vector76/big_arm/docs/open-questions.md

# Open questions

The ⭐ items block the most downstream work. Answers get folded into
[requirements.md](requirements.md) and new design docs as they arrive.

## Still open

1. **Sensing details.** The core concept is now captured in
   [sensing.md](sensing.md) — unloaded-reference optical metrology (readout
   gears for joint angles, floating reference beams for link bending, cheap
   camera modules as the universal readout). Remaining sensing-specific
   questions (sensor count/placement, camera data path, calibration method,
   upper-arm beam geometry) live at the bottom of that document.
2. **Reduction mechanism trade.** Analysis and measurement plan in
   [reduction-trade.md](reduction-trade.md). Shoulder leading hypothesis:
   printed herringbone primary (6.375:1) + capstan cable
   sector (~23.5:1) — η ≈ 0.85, margin ~1.96, zero backlash, drift killed by
   absolute optical sensing. Wrist leans worm; elbow leans worm if measured
   η ≥ 0.5. Closes when the bench rig produces measured efficiencies.
3. **Required feedback resolution and rate.** The repeatability target
   (±1 mm mandatory / 0.1 mm stretch) gives a ~1.1 mrad total angular
   budget — roughly 0.3 mrad per contributor. Rate still open; slow motion
   means even ~10 Hz correction may be plenty. Validate against the Phase 1b
   sensing measurements.
4. **Material trade: plywood box-truss vs. inexpensive pine boards.** Nothing
   purchased yet. Pine boards are cheap and need no sheet-cutting; plywood
   trusses have better strength-to-weight and suit the CNC. Could mix.
5. **Counterweight material and form.** Cheap dense mass: steel bar stock,
   concrete, sand-filled boxes, scrap? How weights mount and adjust (fixed
   vs. positionable along the stub)? Joint-mounted motors contribute some
   mass but nowhere near enough on their own. Note the stub-length limit
   (~half link length) roughly doubles the required mass vs. a full-length
   stub.

The first milestone question is resolved: the concept model is scaffolded
and running in `model/` (torque/counterbalance math + 3D view). With the
datasheet motor curve, load-adaptive cruise speeds, and the elbow restricted
to downward bending, traverse lands at ~2.9 s unloaded / ~6.8 s loaded
(worst joint, full travel) — both the ~10 s unloaded target and the hoped-for
~10 s loaded are met. Shoulder moving margin is 1.61 (pull-out based).
Next milestones: single-joint testbed, then full-arm CAD in OpenSCAD.

## Resolved

### 2026-07-09 (ninth round)

- **Anti-backlash gear primitive:** radially-preloaded printed herringbone
  pairs (compliant mechanism maintains slight center pressure) — proven in
  the user's prior work, effectively zero backlash. Preferred primary-stage
  building block.
- **Shoulder drivetrain hypothesis:** herringbone primary + capstan cable
  sector, ~150:1 total, first prototype of Phase 1a; becomes the final
  design if it measures well.
- **Testbed geometry:** real 0.45 m upper-arm length with balanced dummy
  elbow mass + unbalanced torque-equivalent load — not a full-length
  surrogate beam — so deflection sensing and calibration transfer 1:1.

### 2026-07-09 (eighth round)

- **Repeatability target:** ±1 mm at the tool tip mandatory; ±0.1 mm
  stretch goal after full calibration and modeling. Closes Phase 0.

### 2026-07-09 (seventh round)

- **v0 design point locked** (see requirements.md): default model
  parameters with elbow 90:1 and wrist 40:1 (low enough for single-stage,
  non-bulky reductions), shoulder 150:1, yaw 60:1. Holding torque modeled
  at 0.41 N·m — equal to pull-out — treating the quoted 59 N·cm as
  optimistic. Margins 1.61 / 1.94 / 3.90; traverse ~2.9 s unloaded,
  ~6.8 s loaded.
- **Reduction preference:** single-stage strongly preferred at elbow and
  wrist (no bulky large gears, no multi-stage trains). Constrains the
  Phase 1a trade study.

### 2026-07-08 (sixth round)

- **Motors:** the nine on-hand NEMA 17s are StepperOnline 17HS19-2004S1
  (59 N·cm holding, 2 A, 48 mm); 24 V supply to the drivers. Fans possible
  if needed. Datasheet torque curve at 24 V / 2.2 A: pull-out ~41 N·cm flat
  to ~450 rpm, roughly linear decline to ~17 N·cm at 1200 rpm.
  <https://www.omc-stepperonline.com/nema-17-bipolar-59ncm-84oz-in-2a-42x48mm-4-wires-w-1m-cable-connector-17hs19-2004s1>
- **Elbow range of motion:** downward bend only (~135° travel). With ±90°
  wrist travel the same points stay reachable except some above the
  shoulder. Shrinks worst-case traverse and simplifies counterweight
  clearance.

### 2026-07-08 (fifth round)

- **Modeling/CAD tooling:** documented in [tooling.md](tooling.md).
  A self-contained client-side **TypeScript + three.js engineering model**
  (no server — all math is closed-form and runs in the browser; Vite build;
  hostable as static files) for the concept/trade-study phase, with a pure
  model-core module separated from rendering. **OpenSCAD** as the geometry
  source of truth for detailed design. **Python** reserved for offline
  analysis scripts once measured data exists (e.g., calibration fitting) —
  not a live server. FreeCAD held in reserve for STEP/FEM needs; OnShape and
  paid CAD out.

### 2026-07-08 (fourth round)

- **Optical feedback concept:** captured in [sensing.md](sensing.md). Core
  principle: compare loaded members against unloaded optical references —
  an unloaded anti-backlash readout gear pair per joint (amplified rotation
  read by camera via fiducial tag), and a free-floating carbon-fiber
  reference beam alongside long links (deflection read by a macro-focus
  camera on the loaded structure). ESP32-CAM-class modules (<$10) as the
  readout everywhere. Global workspace camera demoted to coarse cross-check.
  Precision comes from offline load/pose calibration fitting a structural
  model that includes unmeasured compliances (bench, base).

### 2026-07-08 (third round)

- **Wrist link:** no counterweight. Short, light, and dominated by
  end-effector mass; the resulting imbalance is accepted and absorbed by the
  motors. Possibly an attachment point for an optional counterweight for
  very heavy end effectors.
- **Exactness of balance:** perfect neutrality is *not* required — the
  unbalanced wrist link settles this in principle; the motors' torque budget
  absorbs residual imbalance.
- **Counterweight stub length:** limited to ~half the length of the parent
  link, to avoid collisions and workspace restriction.
- **CNC work envelope:** ~3 ft × ~2 ft.

### 2026-07-08 (second round)

- **Payload rating convention:** 5 lb is the minimum over the entire
  workspace, including full extension; more is expected closer in.
- **Speed floor:** any pose to any pose, unloaded, in ~10 s. Soft — may be
  relaxed if counterweight inertia demands.
- **Mounting:** bolted to a bench; base need not be self-ballasting.
- **Base yaw travel:** limited rotation is fine (±90° may suffice, up to
  ~240° if useful); no continuous rotation or slip ring.
- **Counterweight topology:** masses live on the members — bar behind the
  elbow balances the forearm about the elbow axis; the upper arm extends
  behind the shoulder with mass balancing the whole arm. Multiplicative
  counterweight growth accepted; slow acceleration makes the inertia
  tolerable.
- **End-effector swaps:** tentative plan for auxiliary counterweight
  positions (extra pins behind elbow/shoulder) to rebalance heavy end
  effectors.
- **Sensing architecture:** all three layers — joint angles, link bending,
  and approximate endpoint position (e.g., camera) — with redundancy across
  layers used to self-calibrate the motion/deflection model.
- **Stepper drivers:** open-loop. Dominant error enters downstream of the
  motor; design for torque margin instead of skip-step detection.
- **Fabrication tools:** CNC router and a 3D printer for supporting parts.
- **Controller:** spare 3D-printer-class boards on hand (Marlin today,
  reflashable; custom firmware is in scope). Drives NEMA 17s natively.
- **Parts on hand:** nine NEMA 17 stepper motors.

### 2026-07-08 (first round)

- **Target reach:** ~3 ft (0.9 m).
- **Cost target:** ~$500, excluding tools already owned.
- **Use:** general experimentation platform first; must also do pick-and-place
  and drawing/plotting well.
- **Counterbalance approach:** counterweights (not springs).
