vector76/big_arm/(commit log)

2026-07-08 Initial concept documents for big_arm
    Vision, draft requirements, and open questions for a large, cheap,
    deliberately slow robot arm: plywood box-truss structure, full gravity
    counterbalance (counterweights + linkage), high-reduction NEMA 17
    drive, and closed-loop optical position feedback. Targets ~3 ft reach,
    ~5 lb payload, ~$500 build cost, 4 DOF plus separate end effector.
2026-07-09 Fold in second and third rounds of requirement decisions
    Payload rated 5 lb minimum at full extension; ~10 s unloaded any-to-any
    traverse (soft); bench mount with limited base yaw travel; counterweights
    on the members with ~half-link-length stubs; wrist link deliberately
    unbalanced; layered redundant sensing (joints + link bending + endpoint
    camera) with self-calibration; open-loop stepper drivers; fabrication
    resources (3x2 ft CNC router, 3D printer, Marlin-class boards, nine
    NEMA 17s). Adds CAD/modeling tooling discussion to open questions.
2026-07-09 Add sensing concept doc: unloaded-reference optical metrology
    Captures the core principle (separate force path from measurement path)
    and its embodiments: unloaded anti-backlash readout gears for joint
    angles, free-floating carbon-fiber reference beams for link bending,
    and a torsion measurement section (single-camera roll is baseline-
    limited; radial camera pair / L-bracket differential isolates twist).
    ESP32-CAM-class modules as the universal readout; global workspace
    camera reframed as coarse model-divergence check; offline load/pose
    calibration as the precision anchor. Cross-linked from README, vision,
    requirements, and open questions.
2026-07-09 Scaffold the engineering model and calibrate it to real hardware
    model/ is a client-side TypeScript + three.js app (Vite): pure model
    core (counterweight sizing, planar statics, stepper torque curve,
    load-adaptive traverse planning, worst-case pose sweep) with 20 unit
    tests, plus a crude 3D view with sliders, live readout, and URL-
    serialized parameter sets.
    Motor model matches the StepperOnline 17HS19-2004S1 datasheet at 24 V:
    pull-out ~41 N-cm flat to ~450 rpm, linear to ~17 N-cm at 1200 rpm,
    with holding vs pull-out capacity distinguished. Elbow restricted to
    downward-only bending (~135 deg travel). Default 3 ft / 5 lb design:
    counterweights 1.2 kg elbow / 6.5 kg shoulder, shoulder movin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
2026-07-09 Add phased roadmap from concept convergence to demos
    Six phases with exit gates: converge the concept in the model, retire
    risks on the bench (reduction prototype, sensing prototype, structure
    coupons), shoulder-scale single-joint testbed (full-length beam, 5 lb
    at tip, real-scale counterweight, dummy masses matching the arm mass
    distribution), OpenSCAD detailed design, build/bring-up, sensing
    integration + calibration, then application demos.
2026-07-09 Close Phase 0: v0 design point and repeatability target
    v0 locked: elbow 90:1 and wrist 40:1 (single-stage, non-bulky
    reductions preferred), shoulder 150:1, yaw 60:1; holding torque
    modeled at 0.41 N.m equal to pull-out (quoted 59 N.cm treated as
    optimistic). Margins 1.61/1.94/3.90; traverse ~2.9 s unloaded /
    ~6.8 s loaded. Repeatability target set: +/-1 mm at the tool tip
    mandatory, +/-0.1 mm stretch after calibration (~1.1 mrad total
    angular budget at 0.9 m reach). Roadmap marks Phase 0 complete.
2026-07-09 Phase 1a trade study; shoulder hypothesis and testbed geometry
    Adds docs/reduction-trade.md: per-joint efficiency floors, candidate
    comparison, prototype measurement plan. Shoulder leading hypothesis:
    radially-preloaded printed herringbone primary (~3:1) + capstan cable
    sector (~50:1) - eta ~0.85, margin ~1.96, ~107 N cable tension, drift
    neutralized by absolute optical sensing. Roadmap Phase 2 revised to
    real 0.45 m upper-arm geometry with balanced dummy elbow mass plus
    unbalanced torque-equivalent load, so deflection sensing and
    calibration transfer 1:1. Repeatability flow-down noted (~1.1 mrad
    budget); open questions updated (rounds eight and nine).
2026-07-10 Phase 1a pendulum test stand CAD: complete rig around the drivetrain
    The prototype1 drivetrain parts (herringbone primary + capstan sector)
    now live on a buildable test stand: a vertical 12 mm ply board at the
    bench edge (tab-and-slot base + gussets), a 0.48 m pendulum arm at real
    upper-arm scale with calibrated weight holes, and travel of -25..+95 deg
    from straight-down so one hung mass sweeps torque from -42% to +100% of
    the 26.7 N.m worst case (6.05 kg at the 450 mm hole at horizontal), with
    a zero crossing that exposes any mesh lash.
    Design points settled along the way:
    - Primary is 12T/51T (4.25:1) at 20 deg PA, with the wheel's addendum
    stubbed to 0.65 so its tips clear the small p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
    [arm.scad, assembly.scad, baseplate.scad, bridge.scad, gear_drum.scad, hub_tube.scad, motor_mount.scad, params.scad]
2026-07-11 Prototype1 sector rework: single-ply core + printed channel segments
    The 3-layer ply sector becomes a single 12 mm core with a polygonal
    rim; printed channel segments clip over the rim facets (7 plain + 2
    end variants with integral cable anchors) and carry the true cable
    arc. Cable now terminates inside the end segments; hardware list
    updated (18x M4x20 for segments, arm/hub screws shortened to M4x35).
    [assembly.scad, params.scad, sector.scad, sector_segment.scad, spacers.scad]
2026-07-11 Full-arm concept model with preloaded joint bearing stations
    cad/arm/: iteration-5 architecture — inverted shoulder capstan (fixed
    sector integral with the left board, drive rides the arm), two-ply
    slew-disc yaw with printed ring-gear segments, worm elbow/wrist inside
    the truss hollows, in-plane elbow counterweight (top boom + hook
    parking in the top-board slot at full extension).
    Shoulder and elbow joints are paired preloaded bearing stations
    (joints.scad bearing_station, annotated standalone diagram in
    bearing_station.scad): printed arm bushing + split roll-pin rotate
    with the link, printed fixed bushing piloting an oversized board hole
    holds the main 608, and an M3 through a second thr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
    [assembly.scad, bearing_station.scad, joints.scad, params.scad, truss.scad]
2026-07-11 Taper the arm links: shared 2.1 deg line anchored at the shoulder
    Both links taper at the same per-edge angle and share the elbow depth,
    so at full extension the top and bottom edges read as one continuous
    line from shoulder (165) through elbow (~132) to wrist (~99).
    link_d(back) gives the local depth anywhere on that line; the hook
    slot, elbow counterweight boom/riser (now tilted parallel to the taper
    so the boom clears the top board at full extension), and the elbow
    bottom-chord relief all derive from it. Truss side plates become
    trapezoids; chords are sloped boards lying on the tapered edges.
    Deferred, recorded in params: both worm motors now outgrow their
    hollows (elbow motor through th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
    [assembly.scad, params.scad, truss.scad]
2026-07-11 Beef up the truss members: 28 mm diagonals and chord margins
    Doubled from 14 mm - the zig-zag and top/bottom members now read about
    as wide as the 34 mm sector spokes instead of wispy webbing. The bay
    generator resizes itself (upper arm 3 triangles, forearm 6) and the
    narrow wrist end keeps ~25 mm of triangle height.
    [truss.scad]
2026-07-11 Solid fixed shoulder sector, merged into the left board outline
    The rim-band + three-spoke pattern made sense for a moving sector;
    the FIXED sector wants simple + stiff, and extra weight is free. The
    web is now a solid pie drawn directly in left_board_2d - literally
    one CNC piece, in the board color - with a gusset triangle blending
    the lower tip into the board rear edge (fills the notch at x -80;
    lives at base angles 240..253, outside the drive fan sweep). Only the
    printed rim cable channel remains a separate part (sector_channel,
    replacing cap_sector); sector_core_t/sector_hub_r retired.
    [assembly.scad, joints.scad, params.scad]
2026-07-11 Upper-arm CW rides a solid fan of the boom plate, below centerline
    Task #4: no separate counterweight boom. The drive-boom plate (left
    side only) becomes a SOLID FAN sweeping from the boom down past
    straight-back (arm angles 135..200), and the ~4 kg block bolts to its
    inboard face just BELOW the arm centerline (cw_bend now -2 deg): the
    drive stack mass rides above the centerline, so the closing weight
    hangs under it to land the combined CG on the shoulder axis.
    Fan boundary is travel-derived: outer arc r 338 (any point past arm
    angle 170 passes straight down at some pose, height 420 - r, leaving
    6 mm over the z 76 disc top), then past arm angle ~191.5 a chord to
    the corner at angle 200 / r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
    [assembly.scad, params.scad]
2026-07-11 Elbow CW hangs from a fin grown on the left forearm plate
    The bolted-on riser + top boom give way to a FIN: the left forearm
    plate extends back over the elbow as one CNC piece, bottom edge 2 mm
    above the shared taper line. The same offset rule the boom used still
    covers the whole travel: with a down-only elbow, every fin point only
    gains clearance to the upper arm top chord until it has swung forward
    past the arm end. Closest approach to the elbow axis is r ~40, over
    the r 37.5 worm wheel ring.
    The block stays CENTERED for lateral symmetry: a dog-leg hanger
    crosses from the fin inboard face (y 28) to the center plane, then
    drops through the unchanged centered top-board slot. CG still on the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
    [assembly.scad, params.scad]
2026-07-11 Testbench rides the real base + upper arm; drop the worm proxies
    - assembly.scad refactored into a module kit (bench_env / slew_base /
    upper_arm / forearm_install); render byte-identical before/after.
    - New arm/testbench.scad: slew disc clamped flat to the desk (top =
    disc_z0 keeps final coordinates), no forearm — weight plates ride
    barbell-style on an M8 rod through the empty elbow pilot bores, CG
    exactly on the elbow axis (statically exact forearm stand-in).
    - prototype1 pendulum-stand files removed (assembly, baseplate, arm,
    spacers, hub_tube); drivetrain part files kept as the seed of the
    real shoulder's detail design.
    - Elbow/wrist worm gears + motors removed from the mode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
    [arm.scad, assembly.scad, baseplate.scad, hub_tube.scad, joints.scad, params.scad, sector.scad, spacers.scad]
2026-07-11 Slew disc lowered to 24, hubbed on a flipped bearing station
    [assembly.scad, hub_station.scad, joints.scad, params.scad, testbench.scad]
2026-07-12 Grooved drum + two-track ramped sector: deterministic capstan lay
    - Wrap math corrected: the frozen band MARCHES one pitch per drum rev,
    so drum_len = band + march (41 mm; the old formula missed the march)
    and the sector needs TWO tracks at constant band_w separation, each
    ramping across the arc at the shared ~2 deg lead — zero fleet angle.
    - gear_drum: round-bottom helical groove (cord seats on the floor, so
    the ratio sees cord-diameter error only 1:1). The twist-extrude
    cutter must be an arc-width CRESCENT — an offset circle sweeps a
    hairline ribbon, not a groove (documented; land >= printable width
    sets pitch 1.5 for the 1.1 aramid cord).
    - sector_segment: L-profile segm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
    [gear_drum.scad, params.scad, sector.scad, sector_segment.scad]
2026-07-12 Wedge-backed sector segments; anchors through the band, no walls
    - Segment cross-section per sketch: the outboard end face is wide (the
    inverted print bed), a >=45-deg diagonal closes it down to the leg,
    and the section fills solid behind the tracks — radial backing plus
    support-free printing (V walls, diagonal, up-facing leg land,
    counterbores all print from the bed).
    - Leg screws sit at the bottom of deep 7.5 counterbores from the
    outboard face; screw circle moved to rim-10 so the bores stay inside
    the wedge.
    - Anchor walls removed: the anchored run's slot stops 2 deg short of
    the arc end, the cord continues through a 2.2 hole in line with its
    track and knots in a recess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
    [params.scad, sector_segment.scad]
2026-07-12 Integrate the wedge capstan into the arm: flush lane, real gears
    - col_w 150 -> 140: board inner faces at +-58, a 3 mm running gap at
    the shoulder matching the elbow — ONE bearing-station design serves
    every joint.
    - Sector band ONE-SIDED and flush on the left board's inner face,
    growing outboard (y 58..106.5): sector_channel() now draws the real
    wedge-backed segment profile on the board's circular rim (rim sr-3,
    crest sr+1.4); left board trimmed to match.
    - Drive stack re-zoned outboard: drum band across the sector lane
    (60..105), wheel + pinion past the band's end (108.5..135.5), motor
    sleeved off the boom plate with its face 4 under the gear plane
    (the plunge idiom died)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
    [assembly.scad, gear_drum.scad, joints.scad, params.scad, testbench.scad]
2026-07-12 Consolidate prototype1 into arm/: one folder, one params namespace
    - pinion.scad, gear_drum.scad, sector_segment.scad move into cad/arm/
    and run on arm/params.scad, which absorbs the herringbone primary,
    the capstan wrap math (track_z), segment geometry, and bearing
    basics. Duplication actually dies: cab_w/drum_l/whl_y0 are derived,
    the wrap math runs on shoulder_min/max, and hand-set gear_w gives
    way to the computed one-tooth-phase gear_width.
    - gear_drum() IS the arm's part now (drum inboard, neck, wheel
    outboard, 608s pocketed in); the rig-stacked variant is retired.
    - sector.scad dissolves into left_board_2d: the board carries the
    segment leg-screw pilot circle beside its r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
    [assembly.scad, bridge.scad, gear_drum.scad, joints.scad, motor_mount.scad, params.scad, pinion.scad, sector.scad]
2026-07-12 CAD twin viewer: pose the real OpenSCAD assembly in three.js
    assembly.scad becomes a kit of rigid bodies (forearm_install split into
    elbow_stations/forearm/end_effector; every pose transform now lives only
    in the top-level kinematic tree — renders verified byte-identical).
    export.scad emits each body as colored 3MF in its own joint frame plus a
    frames JSON echoed from params.scad; npm run export:cad regenerates
    model/public/cad/. twin.html loads the five meshes onto the same tree
    and poses them with the four joint angles alone (pose sliders, shareable
    ?pose= URL, opacity fix for OpenSCAD's zero-alpha displaycolor).
    [assembly.scad, export.scad]
2026-07-12 Deploy workflow renders the twin's meshes with a pinned OpenSCAD nightly
    The runner downloads the 2026.06.21 Linux AppImage (the version the
    export pipeline was verified against), extracts it FUSE-free, and runs
    npm run export:cad before the Vite build so model/public/cad/ ships in
    the Pages artifact.
2026-07-12 README: link the live calculator and CAD twin pages
2026-07-12 Flip the drive stack, fatten the drum, draw the sector real
    - gear_drum FLIPPED: 51T wheel INBOARD, straddling the boom plate
    through a kidney cutout; grooved core across the band lane; bearing
    BOSS outboard. Both ends now take full 608 pockets (full-shoulder
    floors + inner-race reliefs) - the old gear-outboard stack jammed
    the free end against the plate, where any pocket severed the core.
    - Printed inboard support slab carries the drum axle end AND the
    motor face (mesh center distance printed-exact, separating force
    loops close inside the print); short outboard bridge; motor points
    back into the arm side.
    - Pinion 12T -> 8T with drum_eff_r x1.5 (10.125): sector radius is
    EXA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
    [assembly.scad, gear_drum.scad, joints.scad, params.scad, pinion.scad, sector_segment.scad]
2026-07-12 Wall in the shoulder drive: two housings, cross-screwed through the boom plate
    The loose standoffs become one-piece printed housings. Inboard: the
    slab grows to reach everything and a shear wall traces the kidney up
    to the plate. Outboard: the bridge rides a C of walls opening toward
    the sector (band and take-off corridors stay clear) plus a spine to a
    fifth boss past the pinion. Screw stations staggered so each housing
    takes wood screws from the opposite face; access holes through slab
    and bridge keep every driver line open. Kidney ring 82 -> 88 for edge
    distance.
    [assembly.scad, params.scad]
2026-07-12 Open the joint bores for real, hull the fork convex, chamfer the forearm root
    The bearing stations could never assemble: the bores were cut only in
    the lobe pieces while the coplanar truss plates blocked them (shoulder
    had no hole at all). Bores now difference through plates + boom plate +
    lobes per link: 15.5 at the moving sides, 28.5 at the elbow fork, 8.5
    at the wrist. The upper arm's elbow fork hulls the plate end into the
    r 35 lobe (convex outline, no waisted notch); the forearm root loses
    its lower-rear corner on the 45-deg line tangent to the r 36 lobe
    (box_truss cut0), with the bottom chord square-shortened to the same
    line. Plus the base bracing: rear heels on both side boards and
    p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
    [assembly.scad, params.scad, truss.scad]
2026-07-12 Lift the drive bend to 55; cut the elbow fold clearance and cap the fork
    shoulder_bend 45 -> 55 rotates the whole swept drive corridor 10 deg
    up off the base woodwork: the blade corner that passed 5.6 off the
    boards' rear edge at full-up now stops at base angle ~241, the
    bridge-plate corridor that grazed the rear gussets clears by ~35 (its
    knee relief removed — the gussets are plain triangles again), and the
    left heel grows to the 244 ray, filling most of the old notch; the V
    left against the sector gusset IS the blade fly-by. The CW fan's
    arc/chord stations are ARM-angle anchored, so they moved in the boom's
    local frame: re-derived for dd 125 (same arm-frame span 143..200, same
    r 338 stra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
    [assembly.scad, params.scad, truss.scad]
2026-07-12 Twin: bare the drive stack, seat the plate on the grid, drag the ee with IK
    upper_arm() grows housings = true: the twin's "upper" export passes
    false, dropping the two printed drive housings so the wheel/pinion/
    drum/capstan stay visible in the viewer (illustration only — the
    assembly, renders and testbench keep them). The CAD datum stays at the
    plate TOP; the viewer lifts its root by plate_t (echoed into
    frames.json from params.scad, never duplicated) so the baseplate sits
    ON the display grid instead of the grid slicing through it.
    Click-drag IK on the end effector: grab the ee mesh (raycast, grab
    cursor), drag its tip on a camera-facing plane, and core/ik.ts fills
    in the joints closed-f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
    [assembly.scad, export.scad]
2026-07-12 Twin: cache-bust the CAD assets per build, hint the IK drag
    The meshes + frames.json live at fixed URLs, and both the browser and
    the GitHub Pages CDN cache them for max-age=600 — so a fresh deploy
    could serve new hash-named JS (the IK) alongside stale meshes, and a
    hard refresh doesn't reach through the CDN. vite now bakes a
    __BUILD_ID__ into the bundle and the twin requests frames.json and
    every .3mf with ?v=<id>: each deploy is a cold cache key, repeat
    visits within a deploy still cache. Plus a small chip under the pose
    panel: click and drag the end effector for inverse kinematics.
2026-07-12 Round the forearm nose, fork the end effector outside it on a third station
    The forearm plates end in a full circular cap about the wrist axis
    (the elbow-cap idiom one joint down), so the EE's flat end plate
    clears it by a pose-invariant 5. The EE is a U-fork in the upper
    arm's 43..55 lane riding the same bearing station as the other
    joints, roles mirrored: green + bolt head on the outer EE cheeks,
    pink + the jam-nut tail hidden inside the forearm box. The dead-axle
    proxy retires. Wrist scale strip on the EE's right rim (200 deg,
    dead-aft camera on the forearm -- the symmetric travel forces the
    azimuth); ee_len is now derived (~67) and flows to the twin.
    [assembly.scad, joints.scad, params.scad]
2026-07-12 Sense the yaw on a rim strip, bulge the disc into a readout lobe
    Yaw travel 180 -> 170 (+-85): the rim is now an exact 360 budget
    between the gear band (travel + 6/end mesh margin, was 10) and the
    white angle strip (travel + 4/end read overshoot = 15 mm at the
    crest), read by a base-fixed camera at azimuth 135 - the pitch-axis
    sensing idiom brought down to the base. The bare arc bulges to
    yaw_lobe_r so the strip crest rides AT the gear band's OD: one rim
    cylinder, so overtravel reads gear instead of striking the camera.
    Testbench clamp screws step out to r 220, past the lobe.
    [assembly.scad, params.scad, testbench.scad]
2026-07-12 Wrist drive: second herringbone primary + capstan loop, motor on the fin
    [assembly.scad, params.scad, wrist_drive.scad, wrist_drum.scad]
2026-07-12 Wrist drive: hug the wood with the cable plane, rotate the motor down
    [assembly.scad, params.scad, wrist_drive.scad, wrist_drum.scad]
2026-07-12 Shoulder capstan: two cables sharing one groove, anchored at the drum ends
    Replace the pinned-midpoint cable with two cables, each knotted at its
    own axial end of the drum core and its own arc end of the sector. One
    winds on exactly as the other pays off, so the lays share the helical
    groove channels and the resident wraps total a constant travel + dead:
    drum core 30 -> 25, part end 101 -> 96, track separation 15.5 -> 6,
    sector band 36.3 -> 29.8. Core inboard end stays at y 62 (wheel/kidney/
    pinion stack untouched); the tracks shift outboard by dead_w instead.
    Wrist drive deliberately keeps the old scheme until this validates.
    [assembly.scad, gear_drum.scad, params.scad, sector_segment.scad]
2026-07-12 Elbow drive: grow the wheel to 66T, wrap a nose capstan on the fork cap
    The shoulder recipe at the elbow, sized to the joint instead of the
    base board. The drum can't shrink (eff_r 10.125 is the 1.1 cord's
    D/d ~18 floor, and tension rises as the arc does the shrinking), so
    the primary grows instead: a third 8T pinion print drives a 66T
    stub-addendum herringbone (8.25:1, riding the same 0.1 inside the
    interference limit as the 51T) into an r 80 NOSE — a single ~150-deg
    printed arc fixed around the upper arm's +y fork cap, foot ring
    seated on the rim, both cable ends anchored in its arc ends. ~65:1
    total (the worm-era 90:1 relaxed); margin ~1.67 at eta ~0.83.
    - elbow_drive.scad: gear_drum's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
    [assembly.scad, elbow_drive.scad, elbow_nose.scad, params.scad]
2026-07-12 Elbow nose folds into the board: cap lobe + groove liner, one shared channel
    The r-80 capstan surface moves INSIDE the plate's thickness: the +y
    fork cap grows a CNC lobe to r 77 and elbow_nose.scad becomes a slim
    ~152-deg printed groove LINER on its rim (body y 43.5..54.5) — the
    cable's radial load presses print onto wood dead-center in the board
    plane, and only three 3 mm screw tabs stand outboard of the 55 face
    (the arc-end pair carries the anchors' tangential pull).
    ONE shared V-channel carries BOTH cables: with the crossed sheaves,
    the two seats are complementary arcs whose bare gap (~6.7 deg, held
    by asymmetric pulley azimuths) is constant at every pose; the
    sheaves sit +-1 mm astri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
    [assembly.scad, drive_housing.scad, elbow_drive.scad, elbow_nose.scad, params.scad]
2026-07-13 Wrist capstan: tangential bridge strap, stack moved 40 back on the fin
    At full-up the old outboard cover (bridge plate + rear wall, y
    80..88) swept just 3.6 over the fixed sector's crest — the user's
    catch — and was the hard wall against moving the stack back. The
    gear and motor never mattered: at y <= 54 they pass between the
    base boards at any radius; it's the y > 55 hardware that must
    respect the sector annulus (r 213..240 about the shoulder, swept
    whenever the arm points up).
    The cover becomes a slim TANGENTIAL BRIDGE: a 16-wide strap across
    the boss aligned with the tangent about the shoulder at full
    extension — the orientation in which sweeping past the sector
    changes its ends'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
    [assembly.scad, params.scad]
2026-07-13 Slew support rollers: 5/16" through-bolt between paired lugs, screwed to the plate
    [assembly.scad, params.scad]
2026-07-13 Hold-down posts: the lug-pair idiom hung over the rim, riser 6 off the envelope
    [assembly.scad]
2026-07-13 Drop both fin drive stacks toward the forearm axis line
    Every mm of stack CG height is closing counterweight the future
    block must supply, so both gear+capstan mechanisms come down:
    - ELBOW: el_axle (-63,198) -> (-80,165). Wheel tips still pass ~26
    over the top chord at full extension; the boss passes 13 in-plane
    under the upper wrist run (which itself dropped with the wrist
    axle). What stops further descent: the drum->dn-sheave span
    shortens to ~56, growing the march fleet there to +-2.3 deg —
    tolerable at a free idler (wall rub, not position error, at
    quasi-static speeds; wide-mouth groove) but flagged for bench
    validation, with the fallback of buying span back at ~1 mm CG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
    [assembly.scad, params.scad]
2026-07-13 Shoulder drum groove: hull-chain sweep replaces the twisted crescent
    Same helix, same round bottom (residue vs the old cutter is ~15 mm^3,
    all at the run-out ends), but the facets now lie along the lay instead
    of crosshatching it as 20-micron slivers. render() bakes the ~1060
    hulls to one mesh so F5 CSG normalization does not explode.
    [gear_drum.scad]
2026-07-13 Capstan grooves: one shared hull-chain cutter for all three drives
    capstan_groove() in lib/capstan.scad replaces the three copies of the
    twisted-crescent cutter (shoulder drum, elbow capstan, wrist capstan).
    Wrist-radius variant verified against its old crescent the same way as
    the shoulder (residue ~24 mm^3, all end tails). All three preview at
    24 normalized CSG elements.
    [elbow_drive.scad, gear_drum.scad, wrist_drive.scad]
2026-07-13 Enhance CAD rendering fidelity and performance metrics
    - Adjusted `rotate_extrude` function in `wrist_drum.scad` to use variable `$fn` based on twin state for improved rendering quality.
    - Modified `herringbone_gear` module in `gears.scad` to allow variable steps for better mesh detail control, and adjusted bore cylinder resolution based on twin state.
    - Added new npm script `export:cad:full` for full manufacturing fidelity exports in `package.json`.
    - Enhanced `export-cad.mjs` script to support detailed rendering options and added triangle budget reporting for performance analysis.
    - Introduced a mesh-cost inspector in `perfHud.ts` to visualize triangle counts and budgets for each body and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
    [bearing_station.scad, export.scad, gear_drum.scad, hub_station.scad, params.scad, sector_segment.scad, wrist_drive.scad, wrist_drum.scad]
2026-07-13 Twin fidelity round 2: straight-flank gears, no carved grooves
    The herringbones' twin default drops to 1 flank step and 1 slice per
    half (7 deg of twist needs no more) — 8.6k -> 2.4k tris on the 51T
    wheel, indistinguishable side by side. The capstan grooves stop being
    carved at twin fidelity entirely: at a coarse seg the hull chain bites
    past the groove envelope and reads as holes through the core wall, so
    smooth beats wrong-looking. Print exports keep 10-step involutes and
    the full 60/24 groove (verified: 53k tris on the wrist core alone).
    Scene: 140.8k -> 86.7k tris, 1.95 -> 1.11 MB. Budgets ratcheted to
    match (upper 49k -> 25k, fore 58k -> 20k); every body back at 81-87%.
